wolfgangfriedrich/P42-VGA/Design/SCH_P42-VGA_ver4.pdf

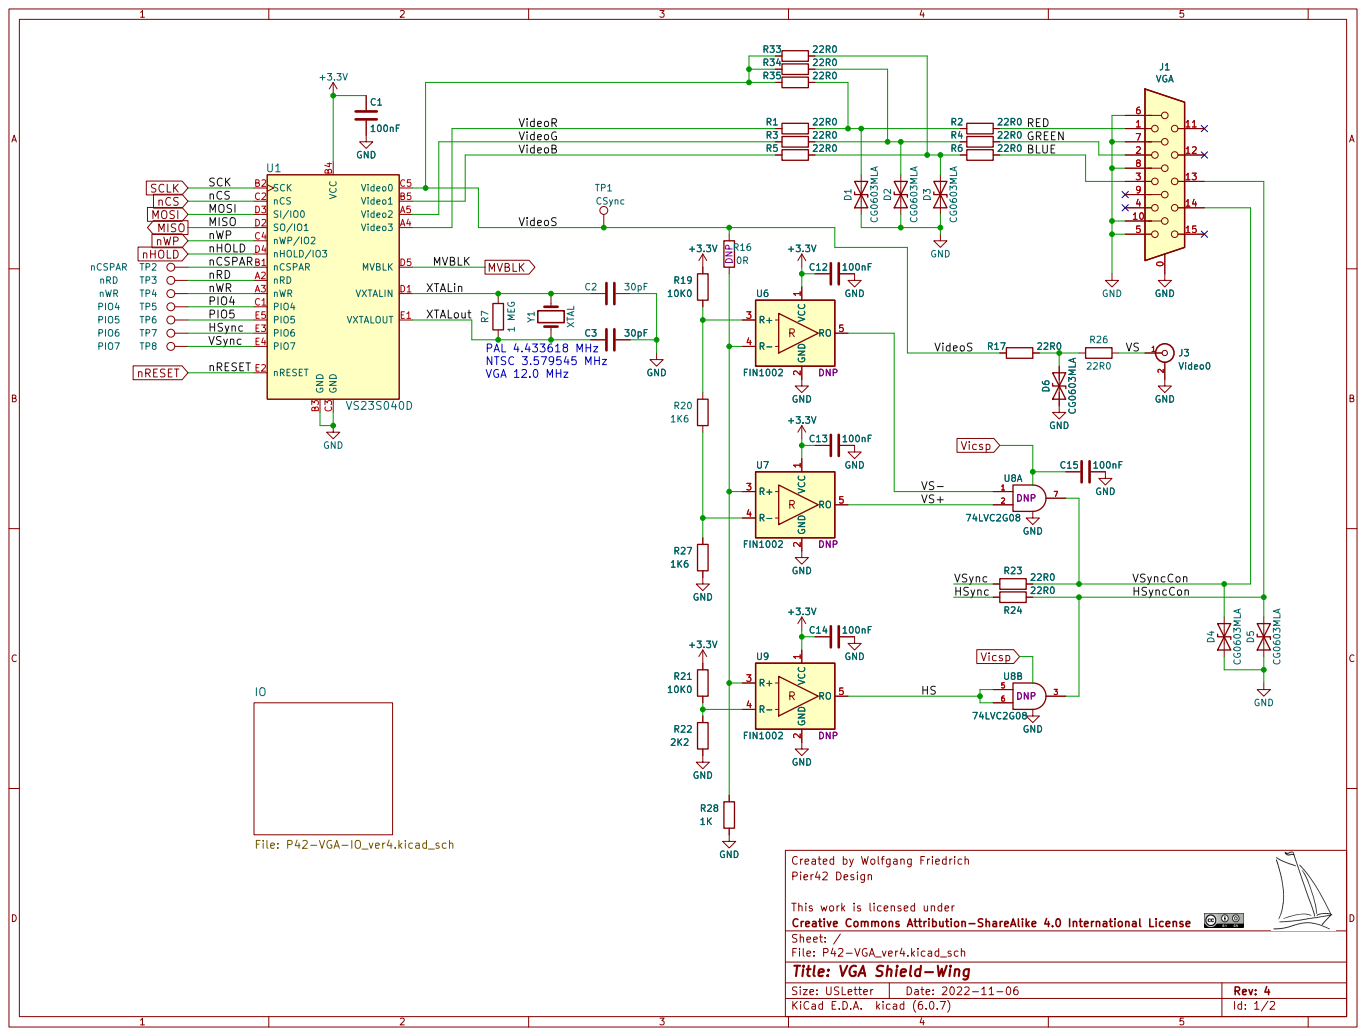
[picture p11: page 1]

PAL 4.433618 MHz NTSC 3.579545 MHz

Created by Wolfgang Friedrich
File: P42-VGA_ver4.kicad_sch Sheet: / Creative Commons Attribution-ShareAlike 4.0 International License This work is licensed under Pier42 Design

Id: 1/2 Title: VGA Shield-Wing

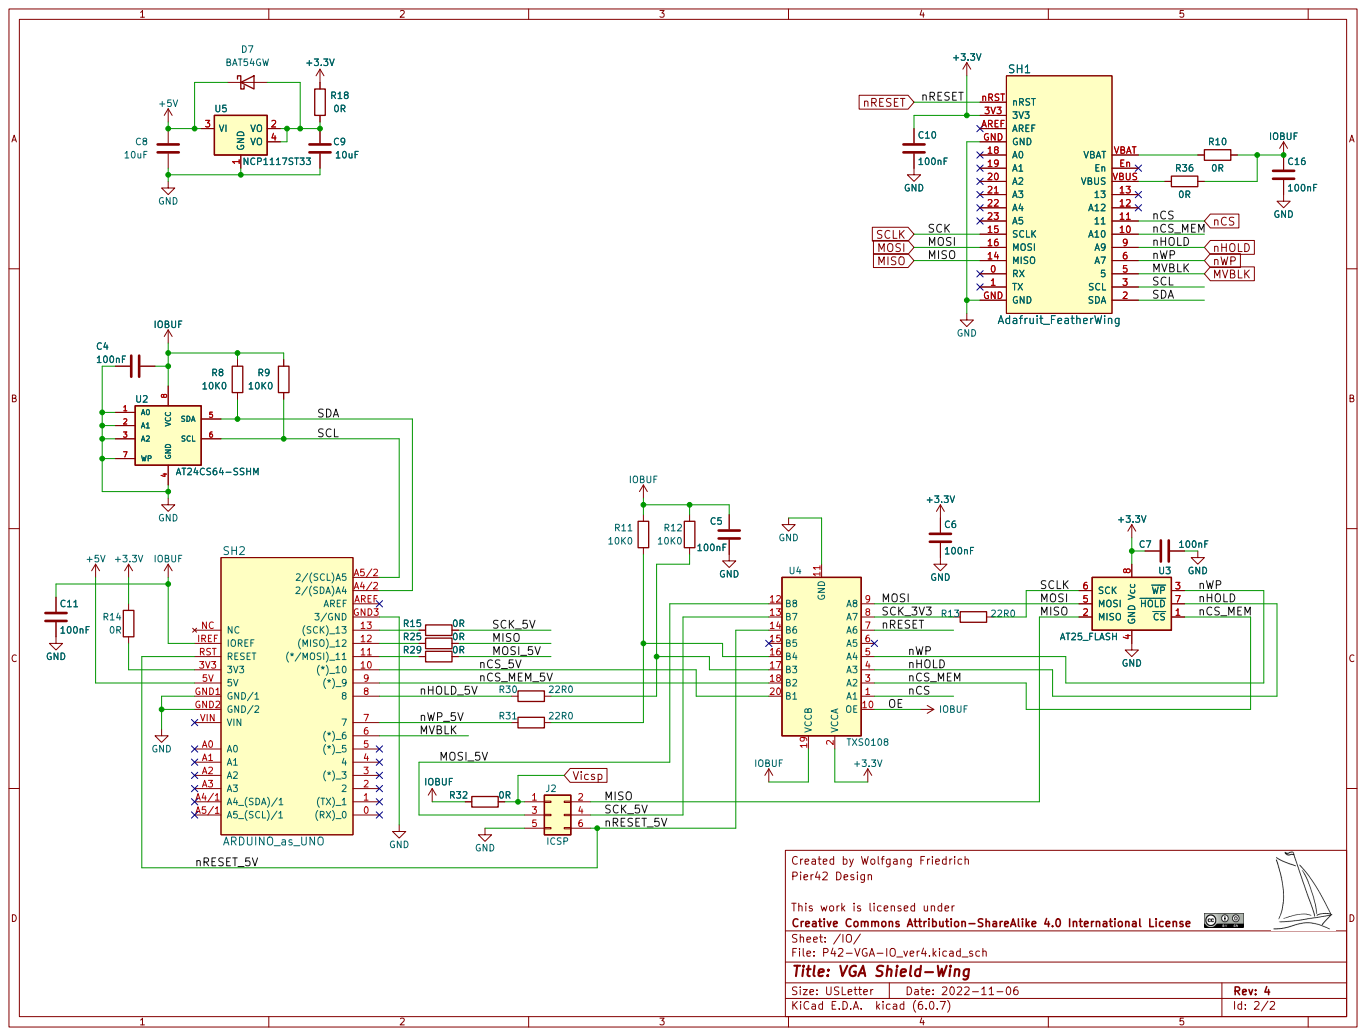
[picture p12: page 2]

4 SDA 5 SCL 6 WP 7 VCC

4 MOSI 5 SCK 6 ~{HOLD} 7 Vcc 8 GND

5V 5V | nCS_MEM_5V | | nCS_MEM

8 | | | nCS

Created by Wolfgang Friedrich
File: P42-VGA-IO_ver4.kicad_sch Sheet: /IO/ Creative Commons Attribution-ShareAlike 4.0 International License This work is licensed under Pier42 Design

Id: 2/2 Title: VGA Shield-Wing
