wolfgangfriedrich/P42-VGA/Design/AD_P42_VGA_rev3.pdf

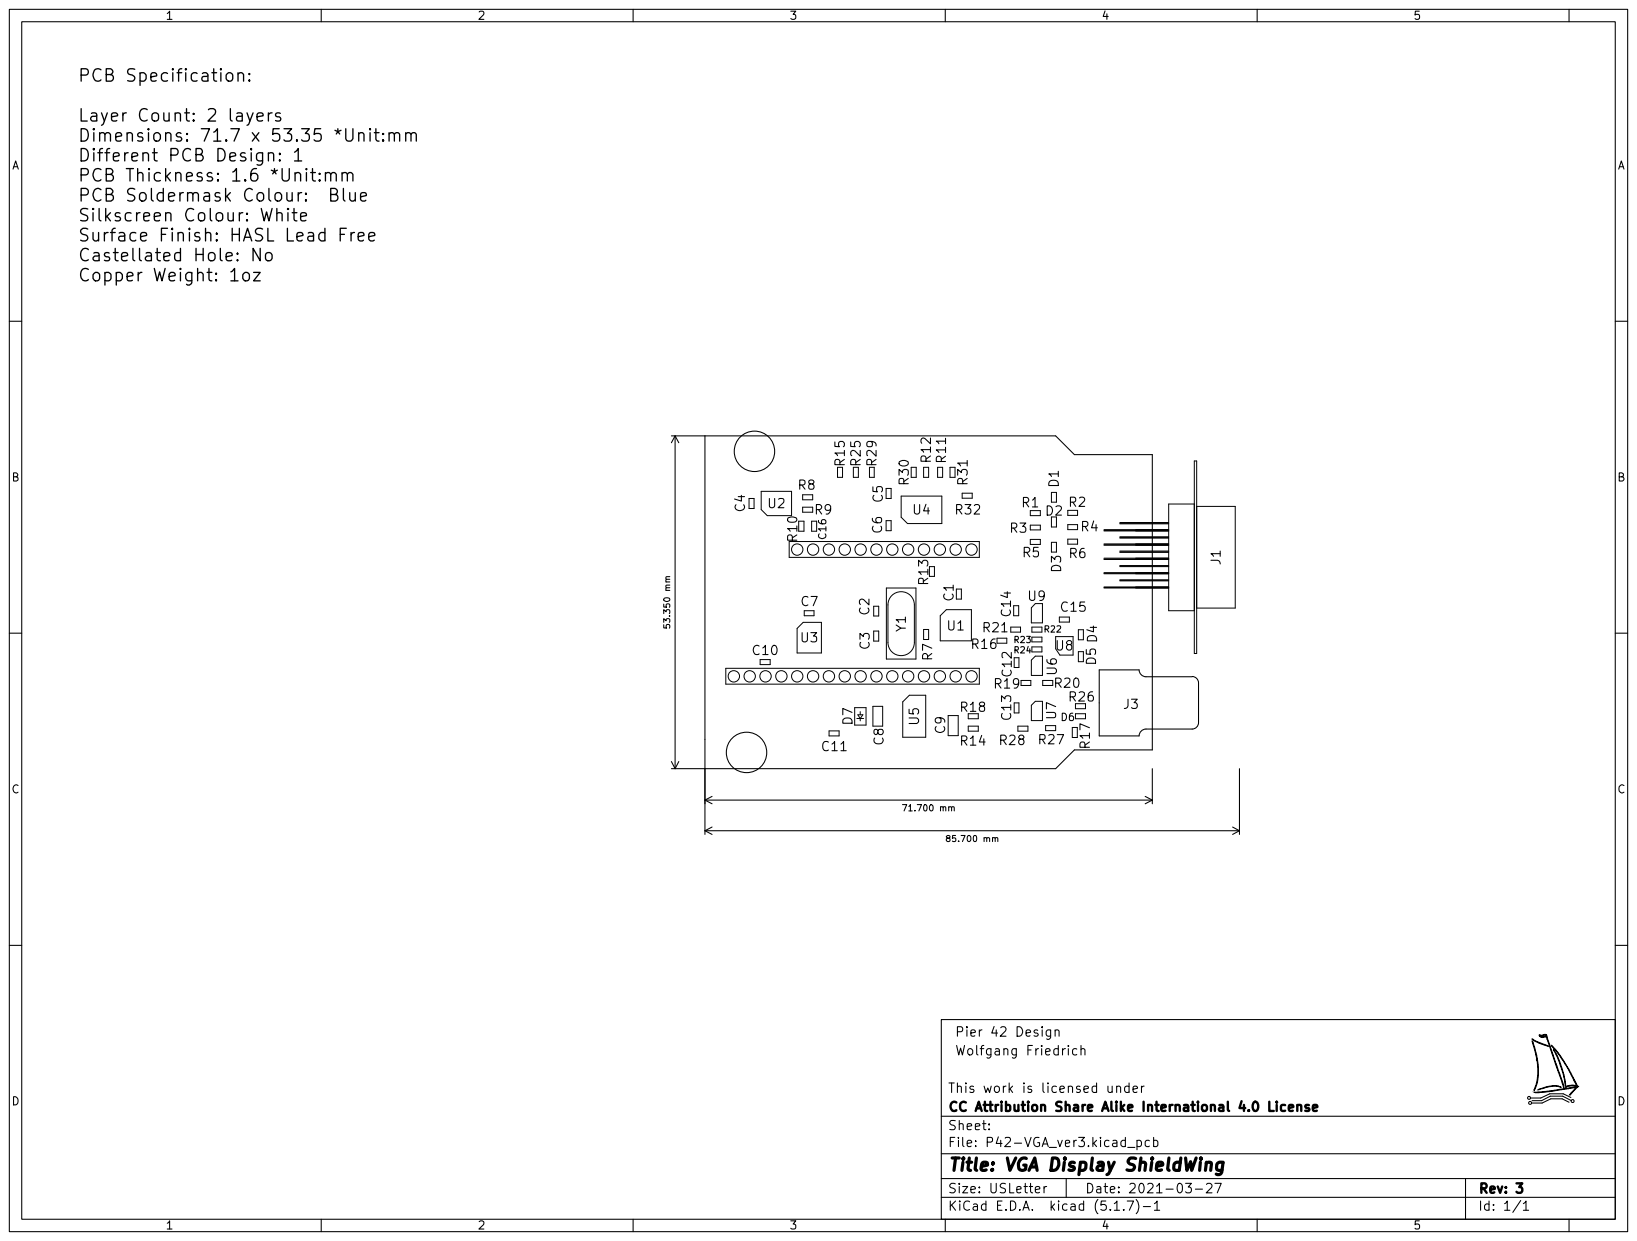
[picture p13: page 1]
