wolfgangfriedrich/P42-VGA/Design/SCH_P42-VGA_ver2.pdf

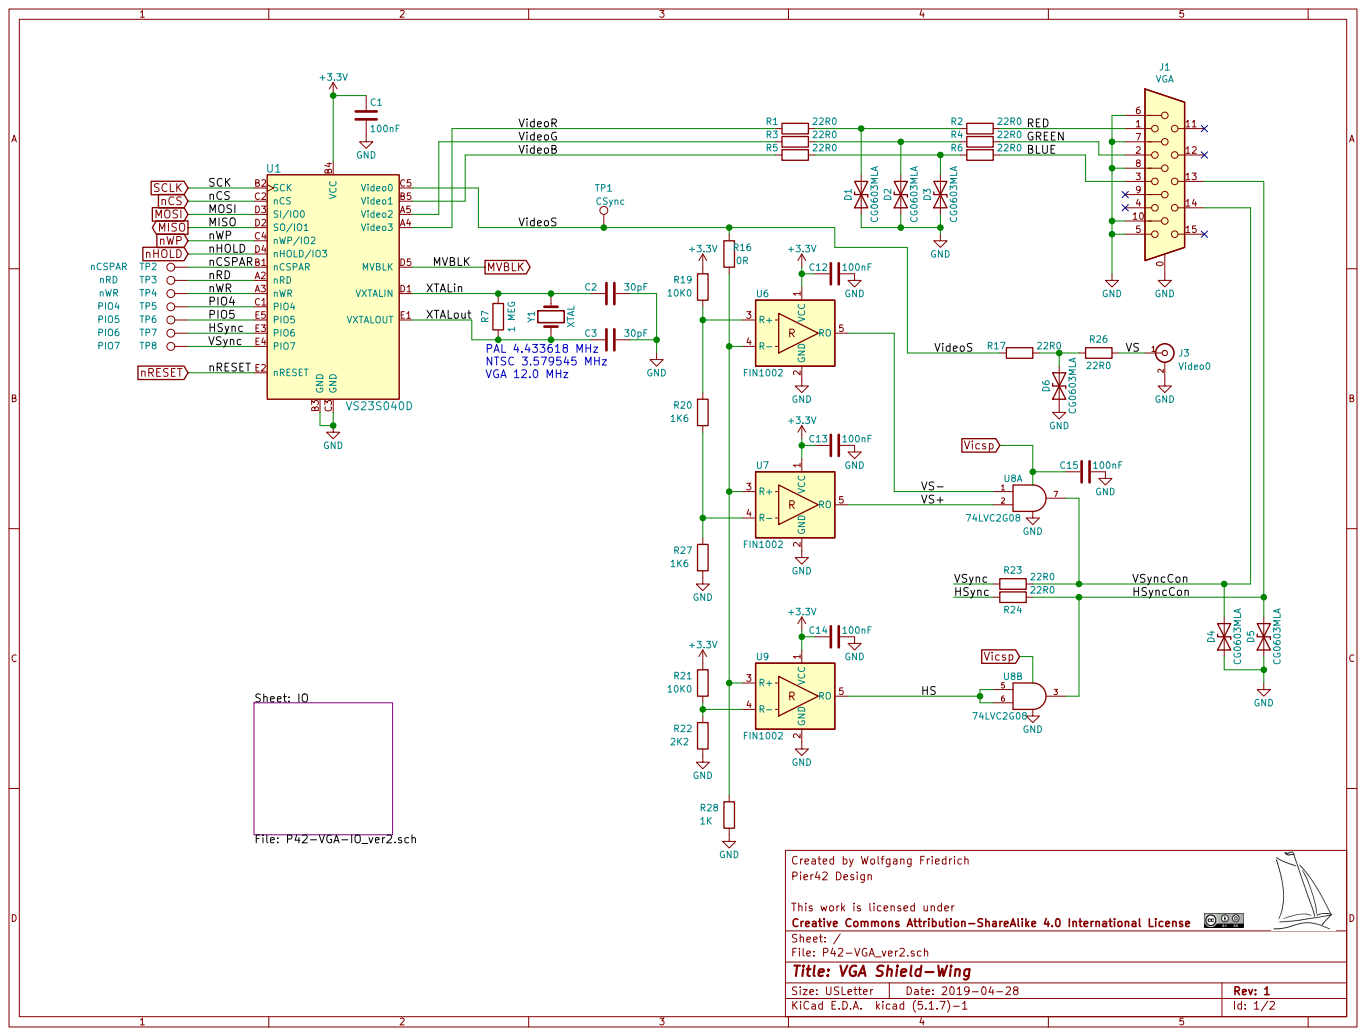
[picture p16: page 1]

VSyncCon PAL 4.433618 MHz NTSC 3.579545 MHz

2 R+ 3 R- 4 RO 5 U7 FIN1002 C13 100nF GND GND GND

Created by Wolfgang Friedrich
File: P42-VGA_ver2.sch Sheet: / Creative Commons Attribution-ShareAlike 4.0 International License This work is licensed under Pier42 Design

Id: 1/2 Title: VGA Shield-Wing

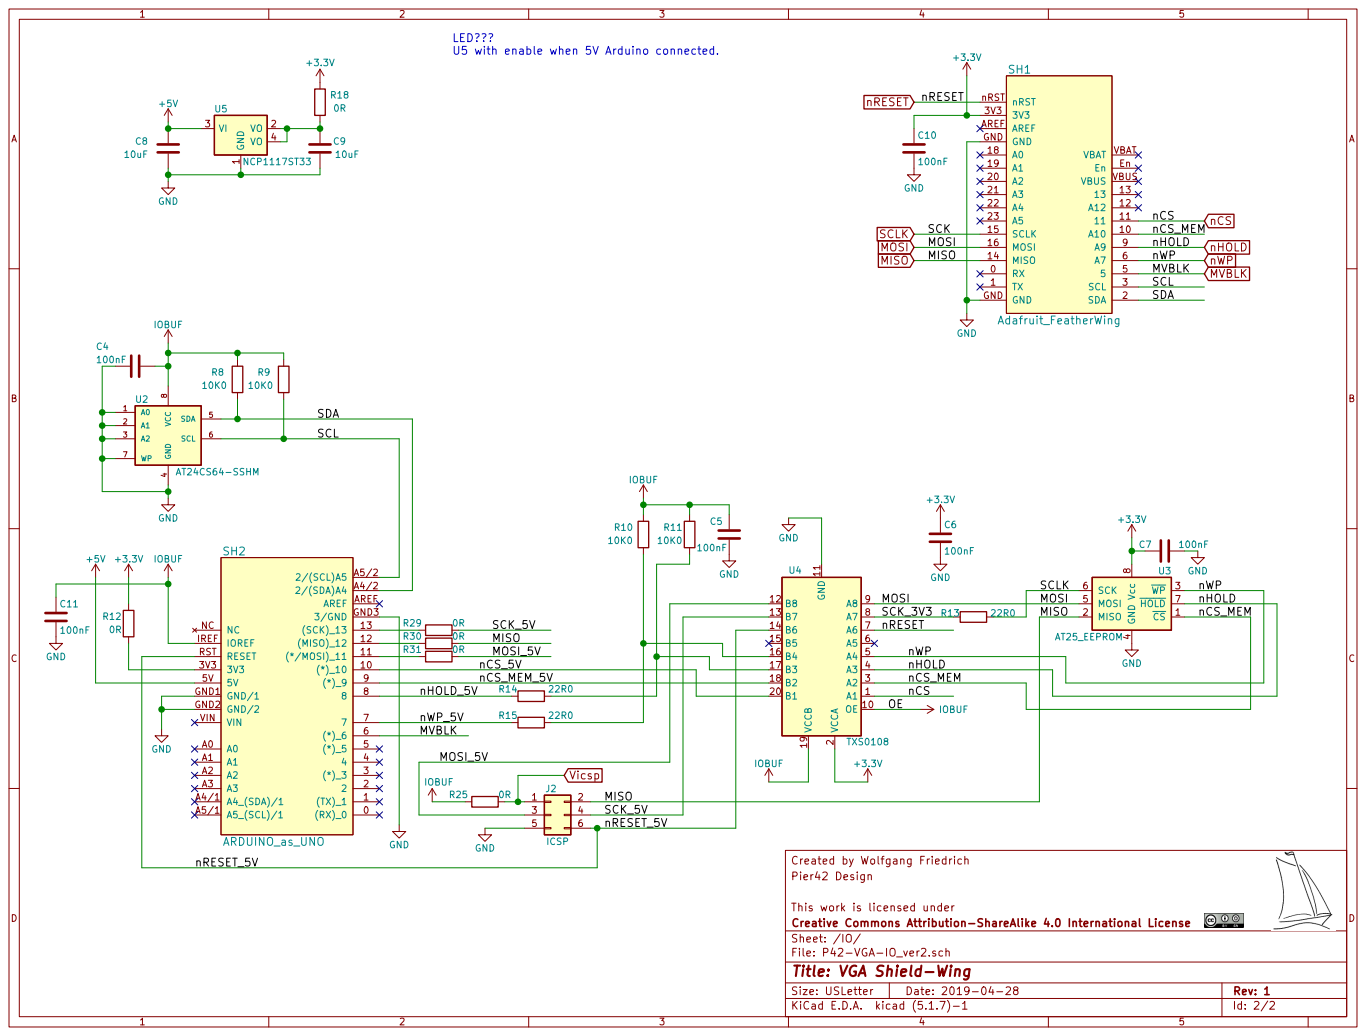
[picture p17: page 2]

LED??? U5 with enable when 5V Arduino connected.

1 VO 2 VI 3 VO 4 U5 NCP1117ST33 C7 100nF GND GND

4 SDA 5 SCL 6 WP 7 VCC

5V 5V | nCS_MEM_5V | | nCS_MEM

8 | | | nCS

File: P42-VGA-IO_ver2.sch Sheet: /IO/ Creative Commons Attribution-ShareAlike 4.0 International License This work is licensed under Pier42 Design

Id: 2/2 Title: VGA Shield-Wing
