wolfgangfriedrich/P42-VGA/Design/AD_P42_VGA_rev2.pdf

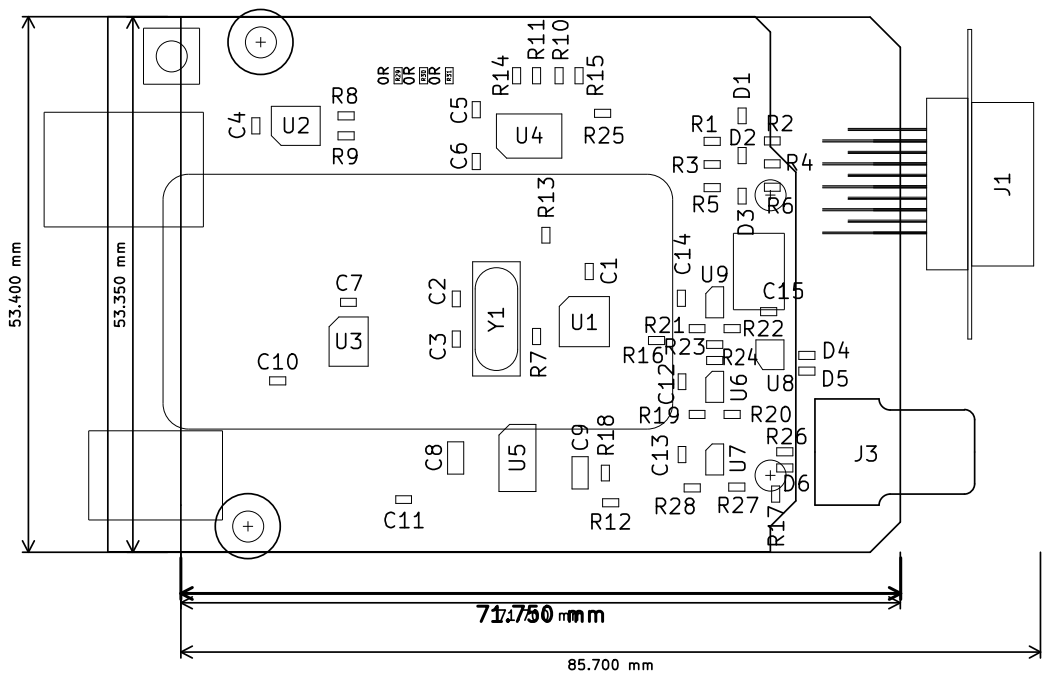
[picture p18: page 1]
