wolfgangfriedrich/P42-VGA/Design/ver2/P42-VGA-IO_ver2.sch

## KiCad design Design/ver2/P42-VGA-IO_ver2.sch (2021-02-03)

Schematic: P42-VGA-IO_ver2.sch

Parts:
C4, C5, C6, C7, C10, C11: 100nF; C_0603_1608Metric_Pad1.05x0.95mm_HandSolder; Mfr1PN na
C8, C9: 10uF; C_1206_3216Metric_Pad1.42x1.75mm_HandSolder; Mfr1PN na
J2: ICSP; PinHeader_2x03_P2.54mm_Vertical_SMD; Mfr1PN NPTC032KFMS-RC
R8, R9, R10, R11: 10K0; R_0603_1608Metric_Pad1.05x0.95mm_HandSolder
R12, R18, R25, R29, R30, R31: 0R; R_0603_1608Metric_Pad1.05x0.95mm_HandSolder
R13, R14, R15: 22R0; R_0603_1608Metric_Pad1.05x0.95mm_HandSolder
SH1: Adafruit_FeatherWing; FeatherWing
SH2: ARDUINO_as_UNO; ARDUINO_as_UNO_R3_CONTOUR
U2: AT24CS64-SSHM; SO-8_3.9x4.9mm_P1.27mm
U3: AT25_EEPROM; SOIC-8_3.9x4.9mm_P1.27mm; Mfr1PN AT25SF161-SSHD-T
U4: TXS0108; TSSOP-20_4.4x6.5mm_P0.65mm; Mfr1PN TXB0108EPW
U5: NCP1117ST33; SOT-223; Mfr1PN NCP1117ST33T3G

Notes on the sheet:
LED??? U5 with enable when 5V Arduino connected.
