wolfgangfriedrich/P42-VGA/Code/P42VGA_PaulFont/Paul12x18font.h

// 12x18 font12x18ext
// hand coded by Paul Ramirez Jonas Studio 
//  in June 2021


const PROGMEM uint16_t font12x18ext[] = {12,18,96,
0x000, 0x000, 0x000, 0x000, 0x000, 0x000, 0x000, 0x000, 0x000, 0x000, 0x000, 0x000, 0x000, 0x000, 0x000, 0x000, 0x000, 0x000,  //Space
0x000, 0x000, 0x060, 0x060, 0x060, 0x060, 0x060, 0x060, 0x060, 0x060, 0x060, 0x060, 0x060, 0x000, 0x060, 0x060, 0x000, 0x000, //!
0x000, 0x000, 0x1b0, 0x1b0, 0x090, 0x120, 0x000, 0x000, 0x000, 0x000, 0x000, 0x000, 0x000, 0x000, 0x000, 0x000, 0x000, 0x000, //"
0x000, 0x000, 0x000, 0x000, 0x000, 0x000, 0x000, 0x000, 0x000, 0x000, 0x000, 0x000, 0x000, 0x000, 0x000, 0x000, 0x000, 0x000,  //# (space)
0x000, 0x000, 0x000, 0x000, 0x000, 0x000, 0x000, 0x000, 0x000, 0x000, 0x000, 0x000, 0x000, 0x000, 0x000, 0x000, 0x000, 0x000,  //$ (space)
0x000, 0x000, 0x000, 0x000, 0x000, 0x000, 0x000, 0x000, 0x000, 0x000, 0x000, 0x000, 0x000, 0x000, 0x000, 0x000, 0x000, 0x000,  //% (space)
0x000, 0x000, 0x000, 0x000, 0x000, 0x000, 0x000, 0x000, 0x000, 0x000, 0x000, 0x000, 0x000, 0x000, 0x000, 0x000, 0x000, 0x000,  //& (space)
0x000, 0x000, 0x060, 0x060, 0x020, 0x040, 0x000, 0x000, 0x000, 0x000, 0x000, 0x000, 0x000, 0x000, 0x000, 0x000, 0x000, 0x000, //'
0x000, 0x000, 0x000, 0x000, 0x000, 0x000, 0x000, 0x000, 0x000, 0x000, 0x000, 0x000, 0x000, 0x000, 0x000, 0x000, 0x000, 0x000, //( (space)
0x000, 0x000, 0x000, 0x000, 0x000, 0x000, 0x000, 0x000, 0x000, 0x000, 0x000, 0x000, 0x000, 0x000, 0x000, 0x000, 0x000, 0x000,  //) (space)
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
0x000, 0x000, 0x000, 0x030, 0x060, 0x000, 0x1f8, 0x3fc, 0x70e, 0x606, 0x606, 0x606, 0x606, 0x70e, 0x3fc, 0x1f8, 0x000, 0x000,  // ó
0x000, 0x000, 0x000, 0x3ce, 0x678, 0x000, 0x6f8, 0x7fc, 0x70e, 0x706, 0x606, 0x606, 0x606, 0x606, 0x606, 0x606, 0x000, 0x000 //ñ
};
