wolfgangfriedrich/P42-VGA/(commit log)

2021-01-19 P42-VGA
    Arduino Shield for 4x Composite Video and VGA (future).
    Also Feather Wing.
    [P42-VGA-IO_ver2.sch]
2021-02-03 Code cleanup _+ doc update
    new gitignore
    remove debug commands to clean up status output
    links updated in user guide
    [P42-VGA-IO_ver2.sch]
2021-03-02 Colour update again
    and fix the repo
    [P42VGA_V4Text.ino, VS23S040D.h]
2021-05-23 BOM rev3
    this
2021-11-10 PaulFont Update
    Demo for PaulFont was only running on a Due. Added correct PROGMEM for
    font data and access function pgm_read_word() functions.
    [P42VGA_PaulFont.ino, Paul12x18font.h]
2023-03-28 VGA with VLSI VS23S040D - WIP
    !!! Caution !!!
    This code is work in progress and highly experimental.
    VGA sync for 640 x 480 seems to be working.
    No pixel display yet. Memory allocation and microcode is broken.
    [P42-VGA.ino, VS23S040D-VGA.cpp, VS23S040D-VGA.h, vga.h, vga640x480.h]
2023-03-28 Create SCH_P42-VGA_ver4.pdf
    Added Schematic for rev4
