wolfgangfriedrich/P42-VGA/(notices)

Notices in the files:
P42 Video4 Shield(rev3) Documentation V1.0.pdf:
Designed by Wolfgang Friedrich Released under Attribution-ShareAlike 4.0 International (CC BY-SA 4.0) https://hackaday.io/project/170499-vga-shield-winghttps://www.tindie.com/products/pier42/4x-video-display-arduino-shield-feather-wing/https://github.com/wolfgangfriedrich/P42-VGA
